thulsonASU/NeurAidBeetlePrototype/(commit log)

2023-04-24 Added mvp board picture and basic description
2023-04-24 Resized mvp board picture
2023-04-24 Added schematic
2023-04-24 Added button void loop section
2023-04-27 Added Final Prototype Photo Header
